kinetic-design/kd-bms-v2/README.md

# kd-bms-v2
Battery Monitoring System Version 2.0 for 192 cells
Designed by Steve Schulz
Kicad V5.1.6 
LTC6804-2 based
