kinetic-design/kd-bms-v2/kd-bms-v2.kicad_pcb

## KiCad design kd-bms-v2.kicad_pcb (2020-07-24)

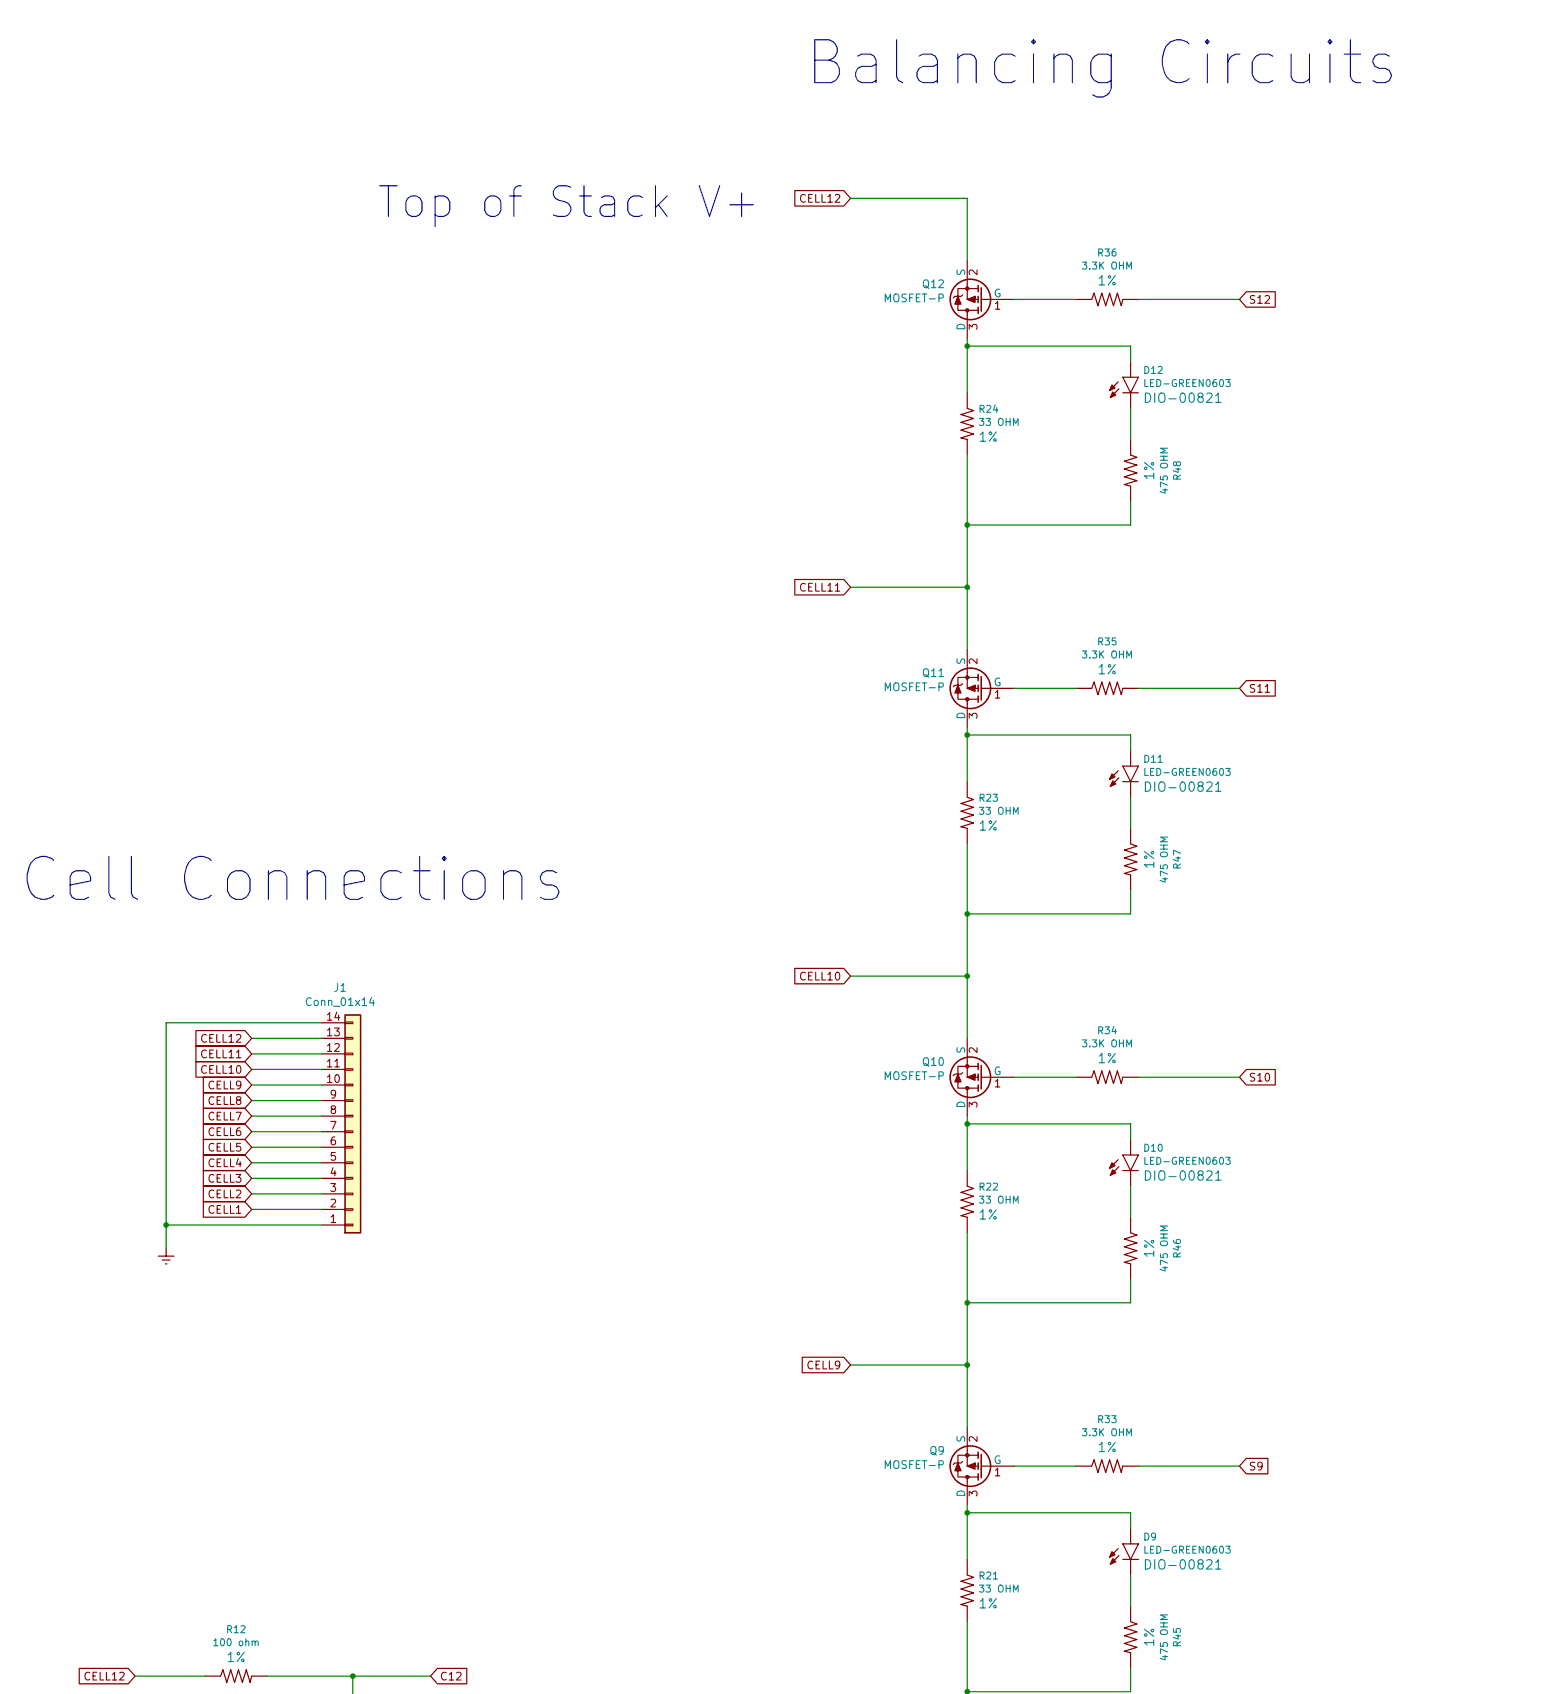
[picture p1: schematic kd-bms-v2.sch, LTC6804IG-2 BMS Slave, part in row 1, column 1]

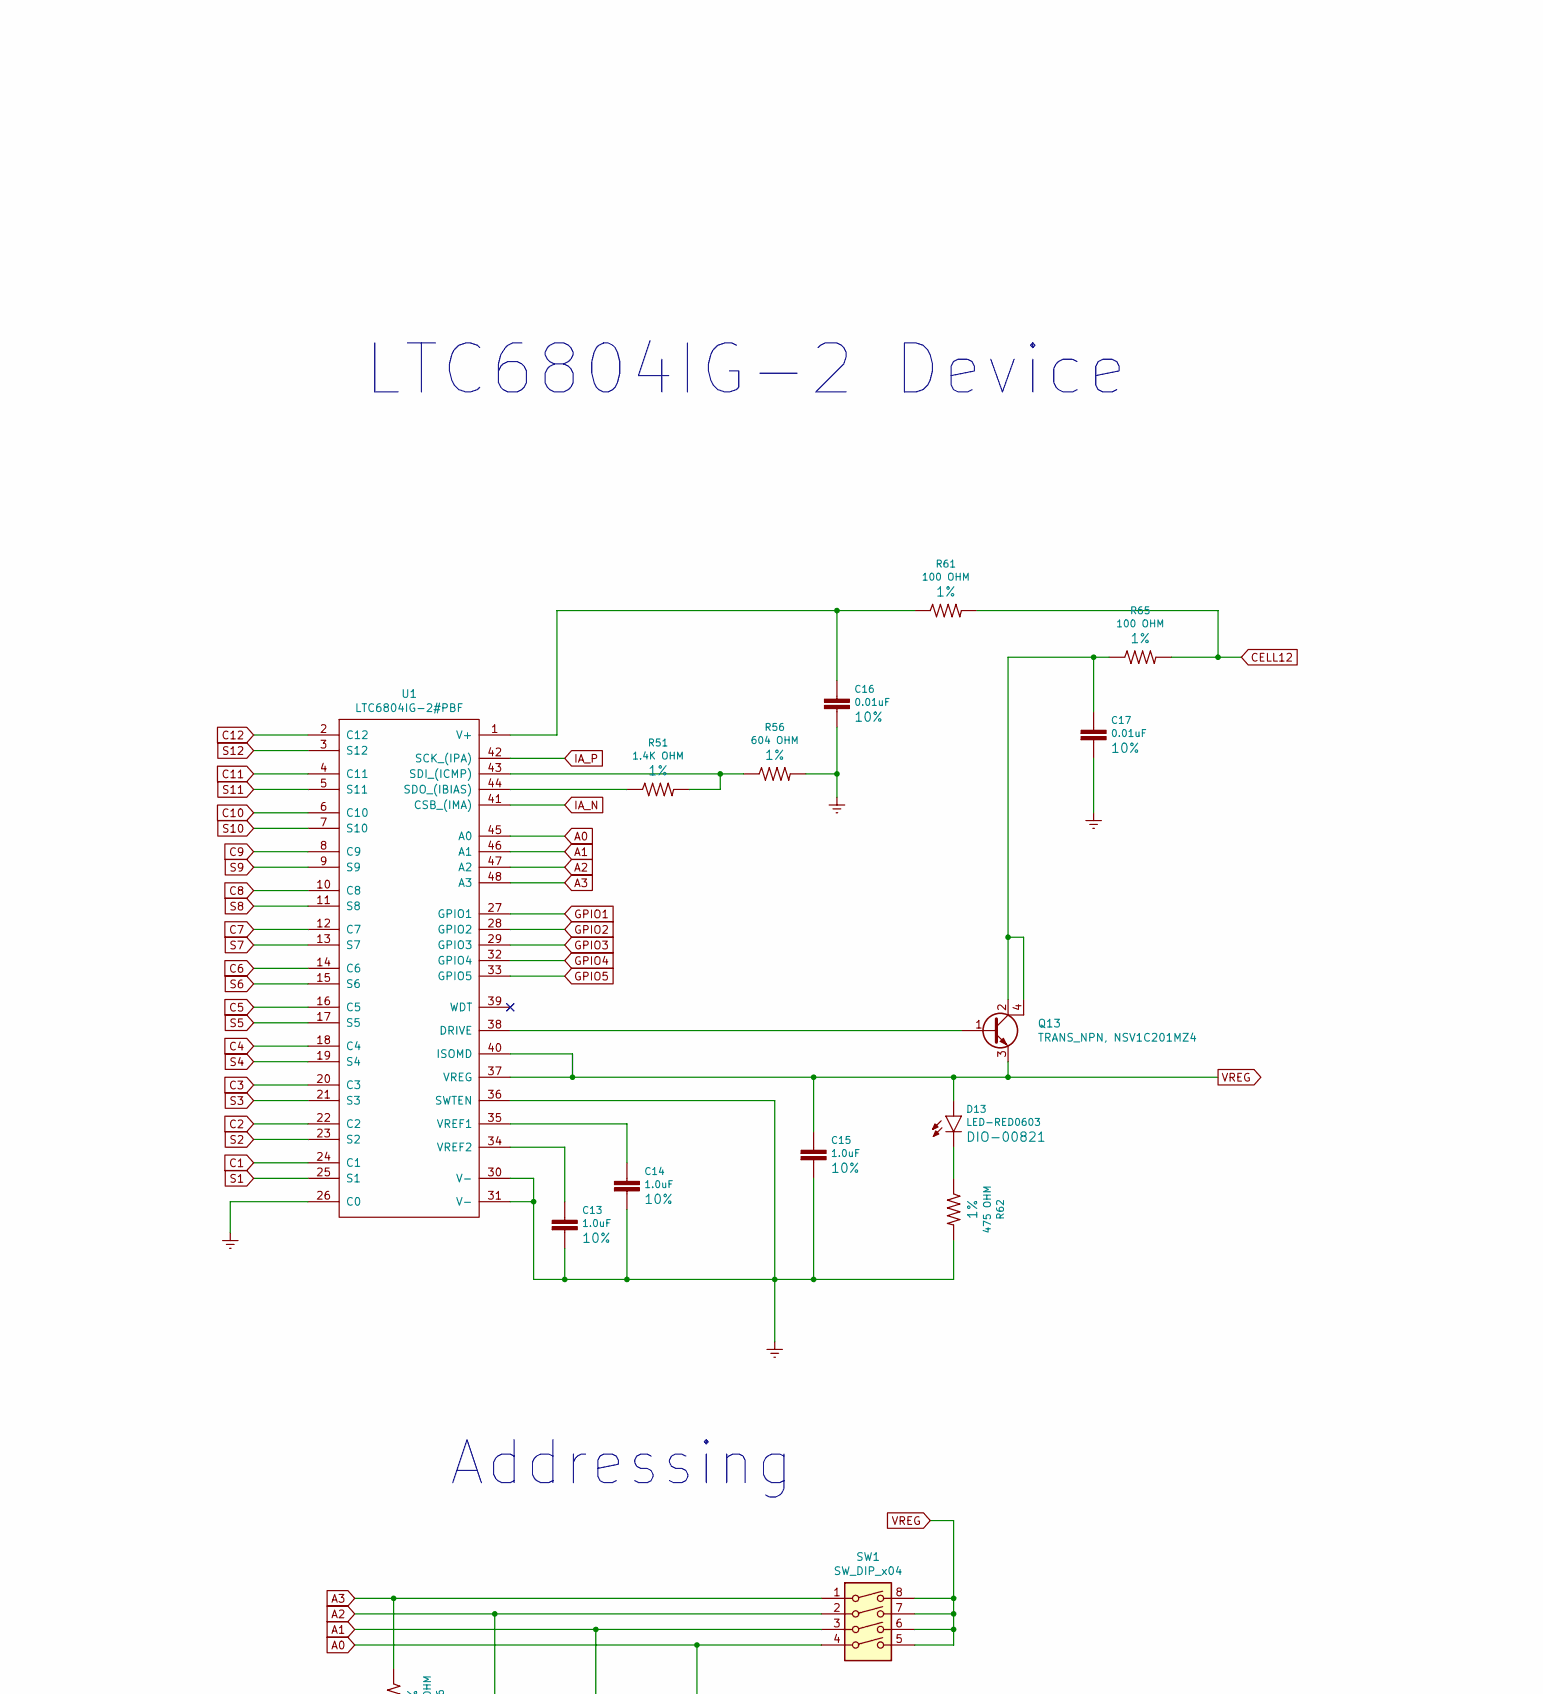
[picture p2: schematic kd-bms-v2.sch, LTC6804IG-2 BMS Slave, part in row 1, column 2]

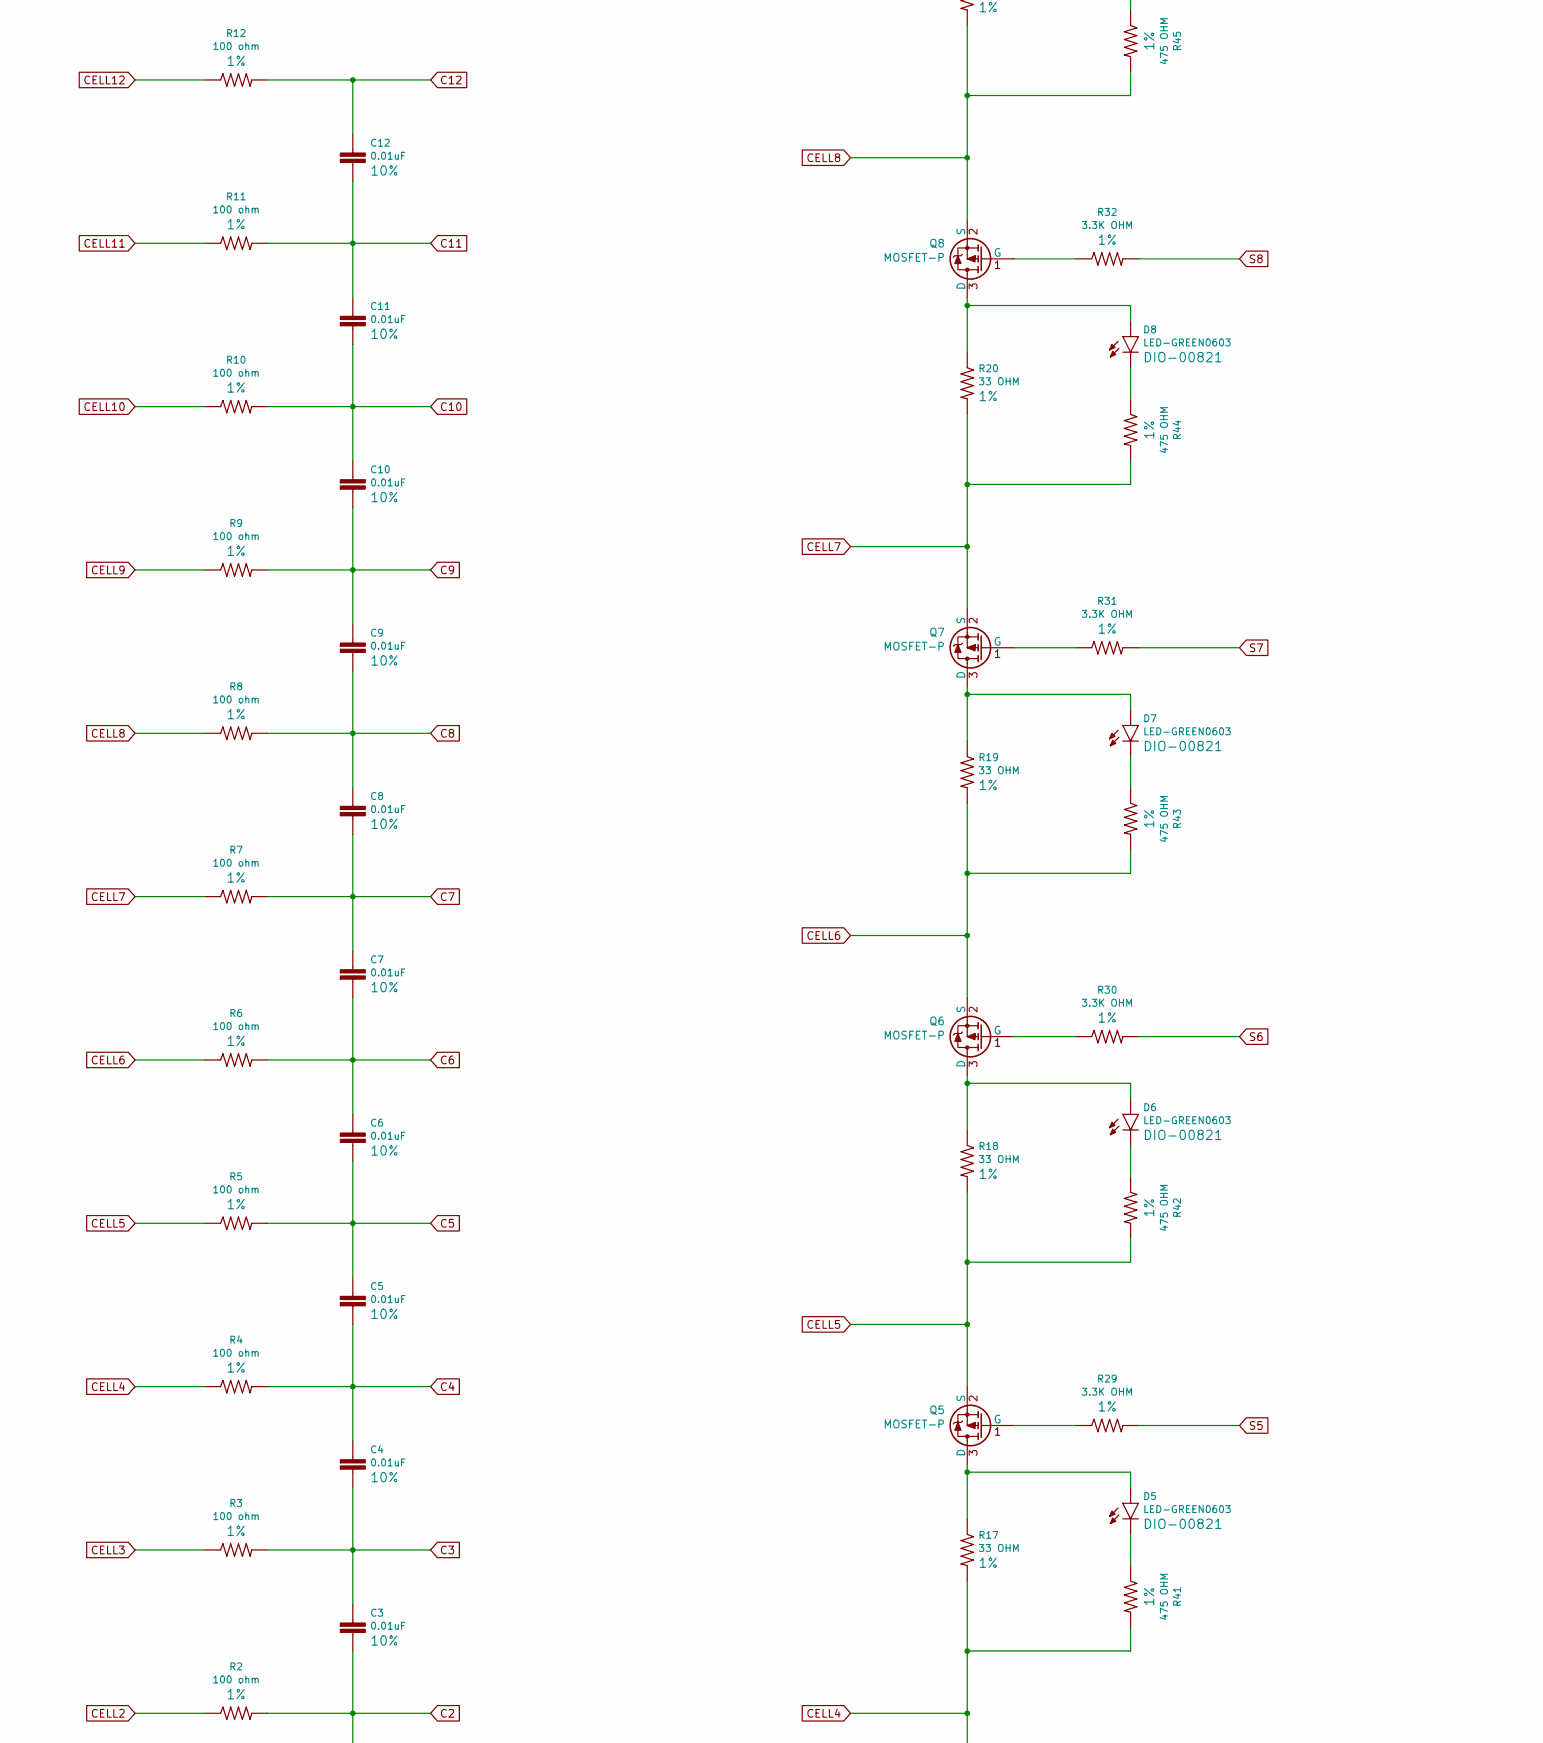
[picture p3: schematic kd-bms-v2.sch, LTC6804IG-2 BMS Slave, part in row 2, column 1]

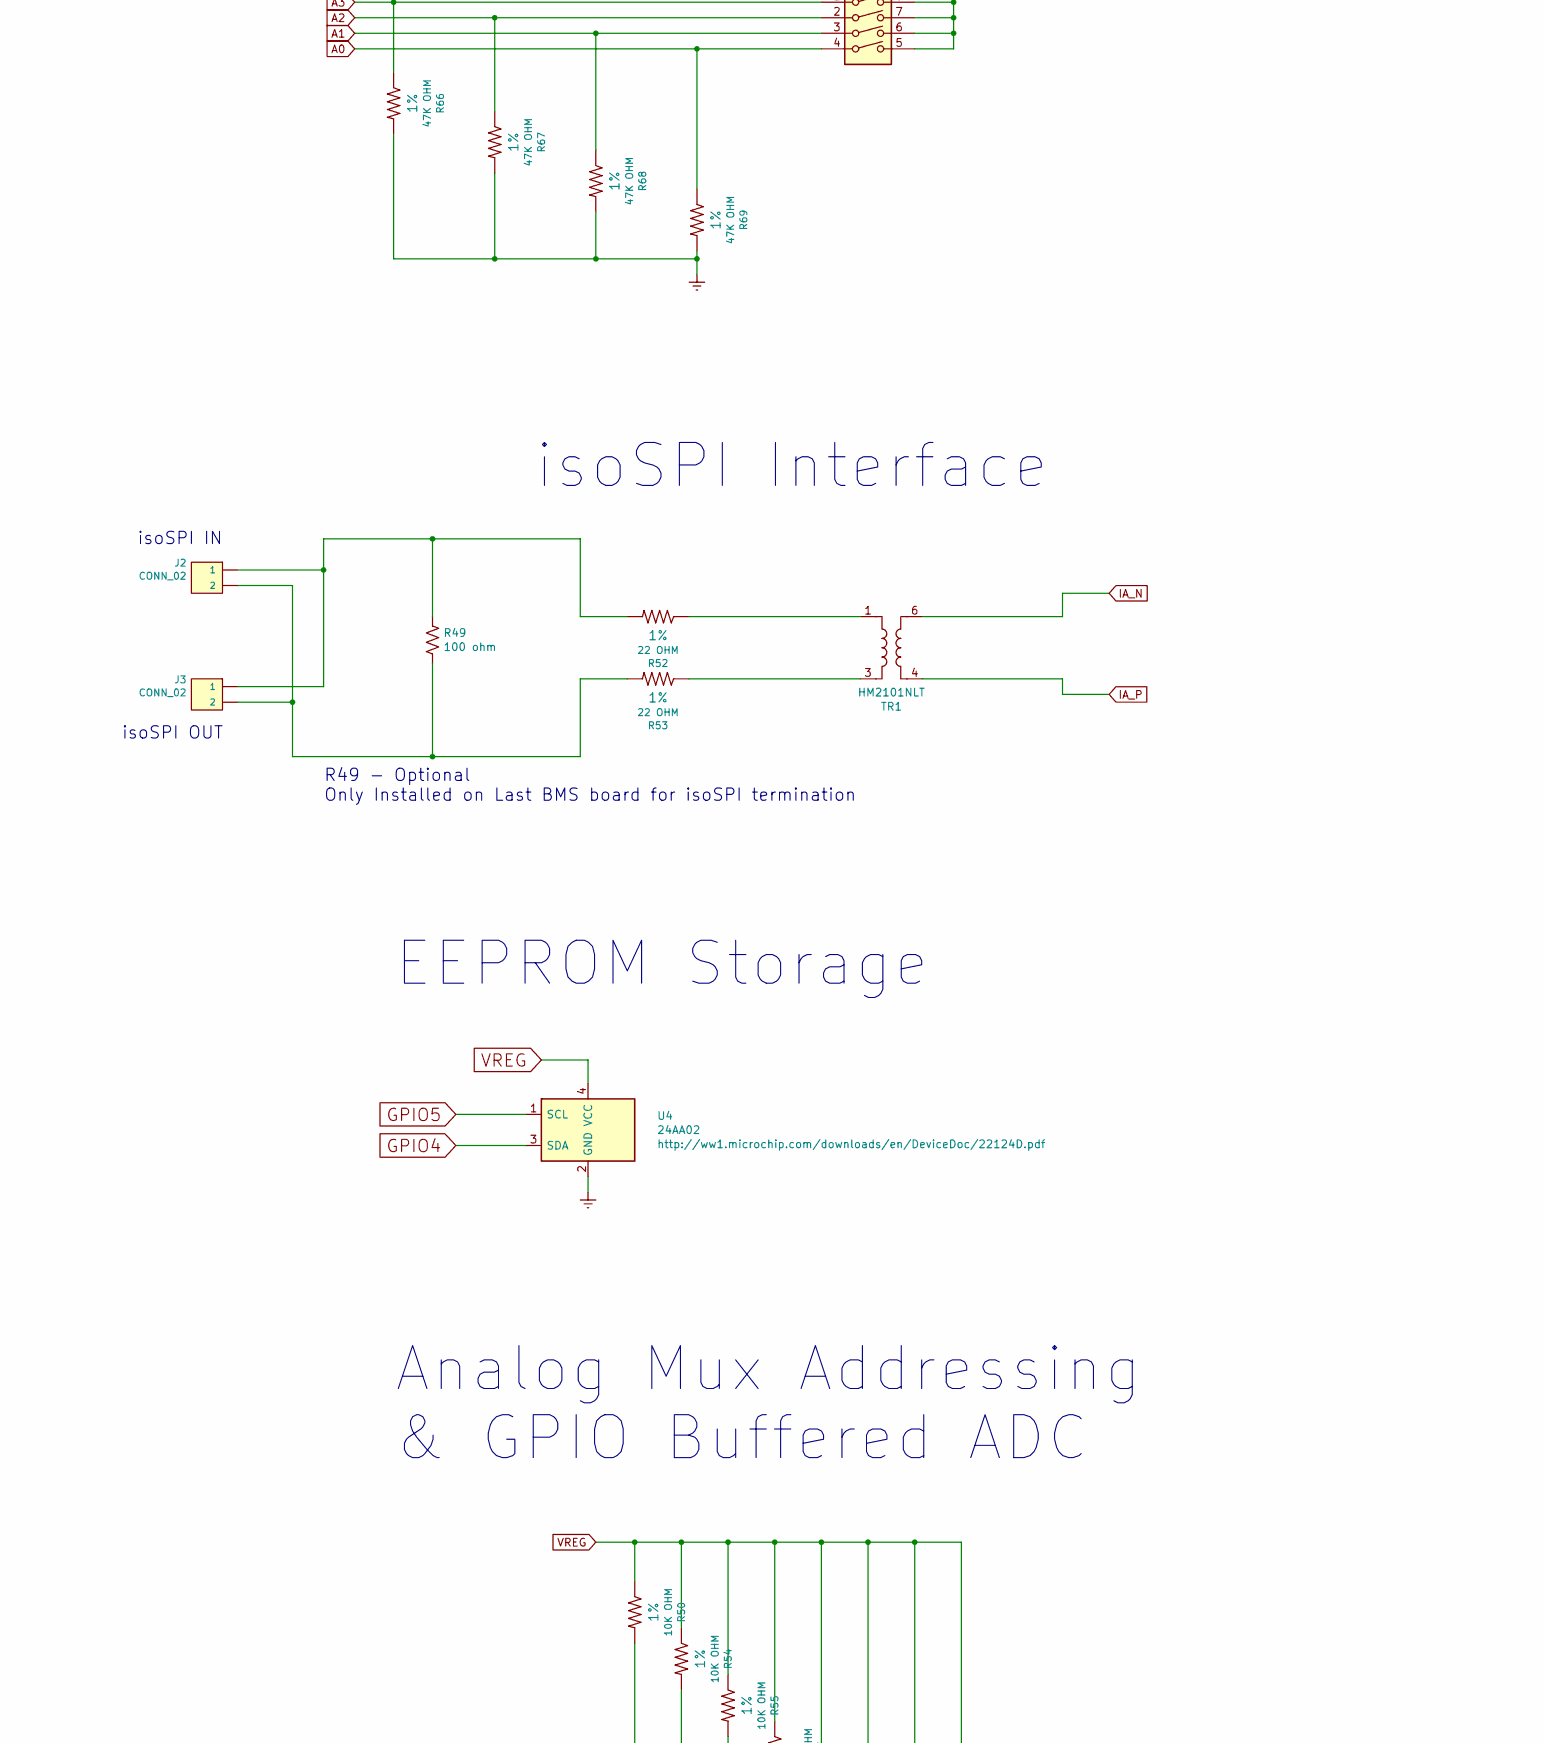
[picture p4: schematic kd-bms-v2.sch, LTC6804IG-2 BMS Slave, part in row 2, column 2]

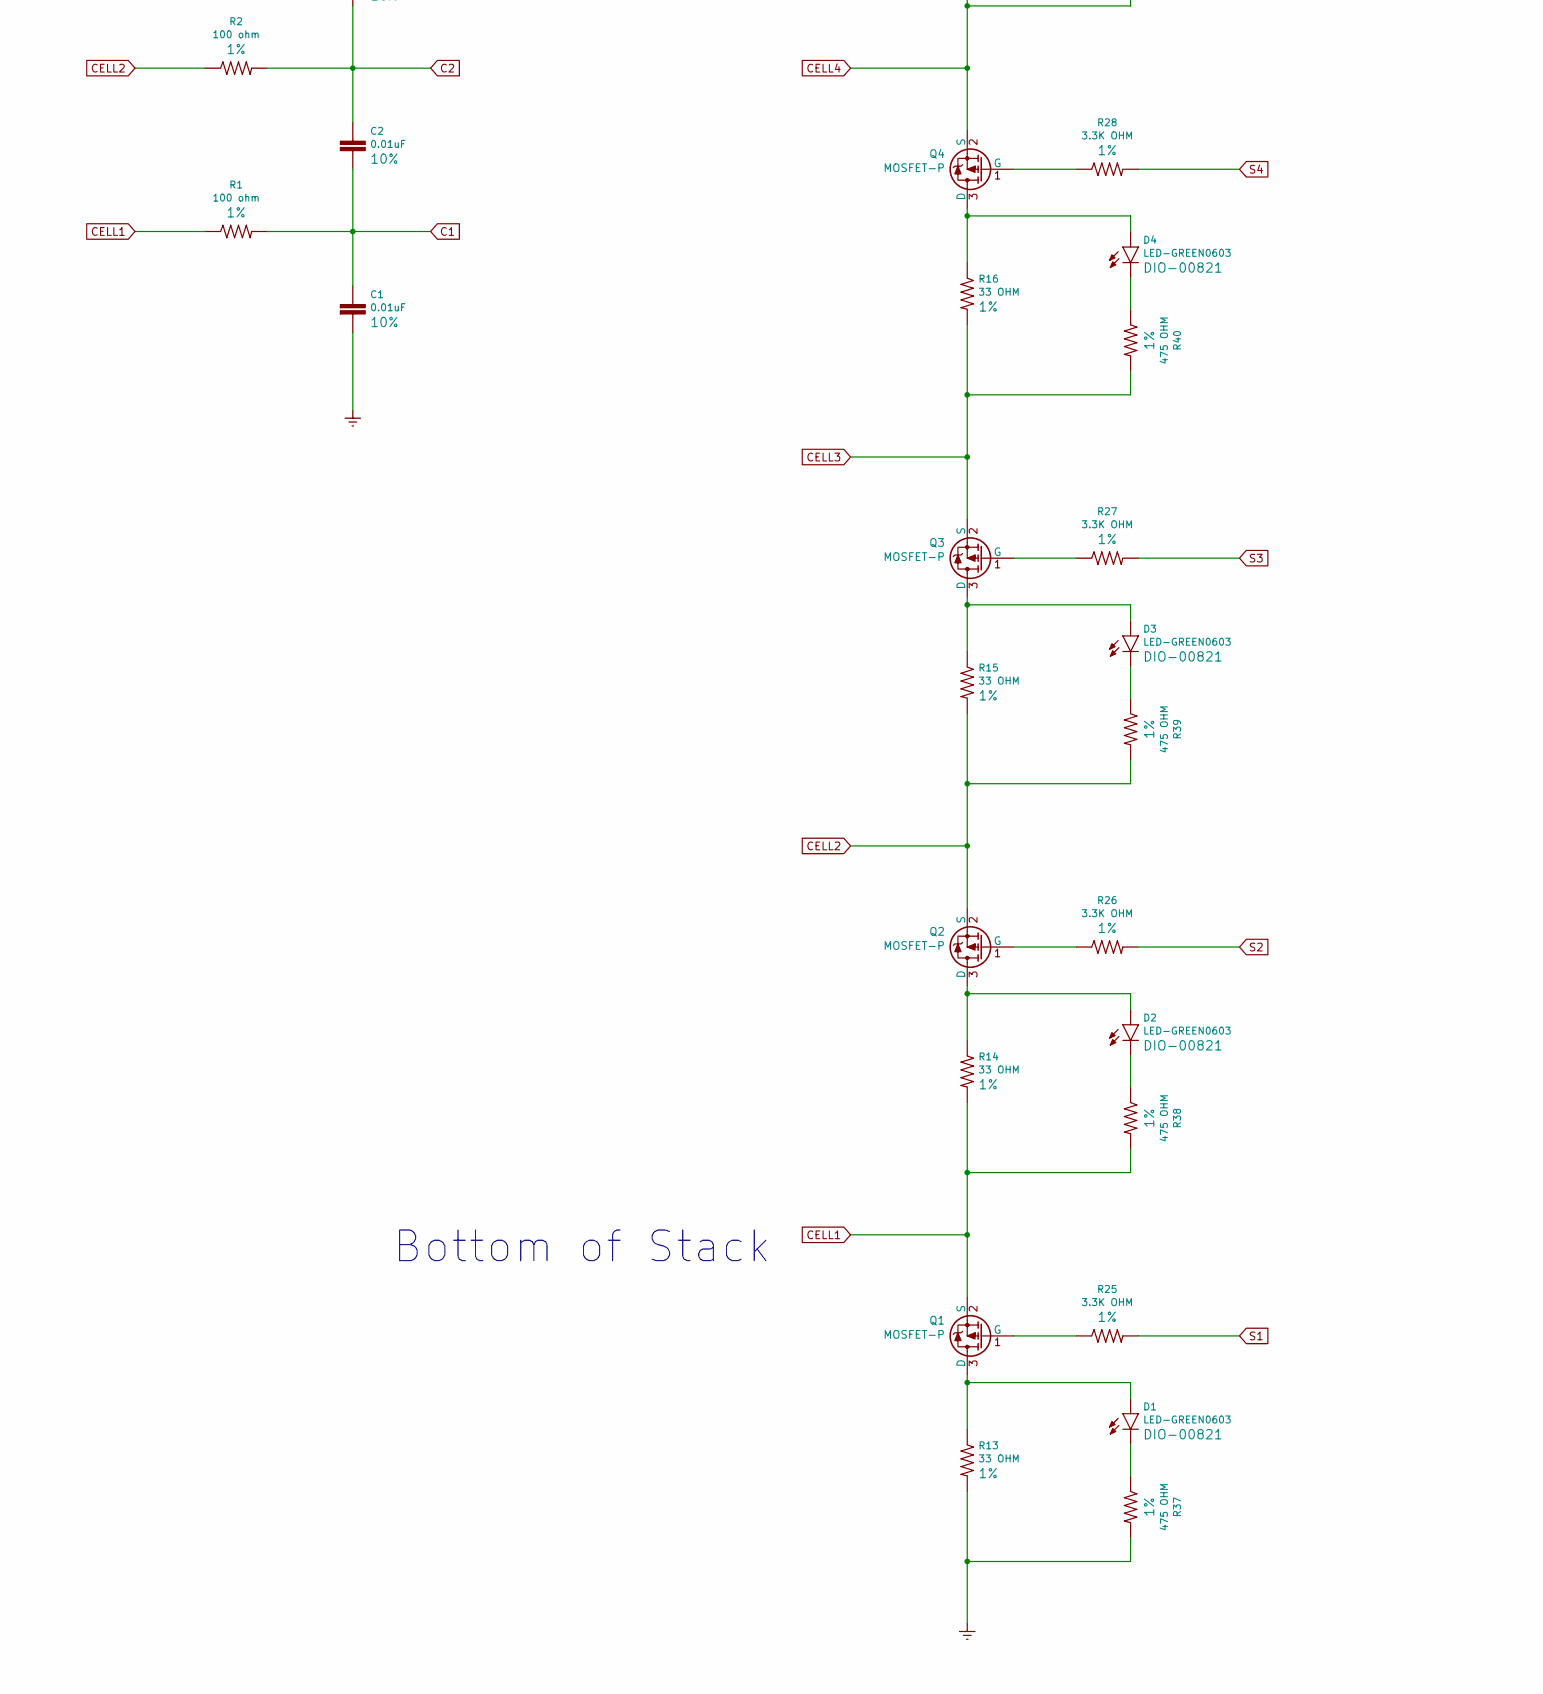
[picture p5: schematic kd-bms-v2.sch, LTC6804IG-2 BMS Slave, part in row 3, column 1]

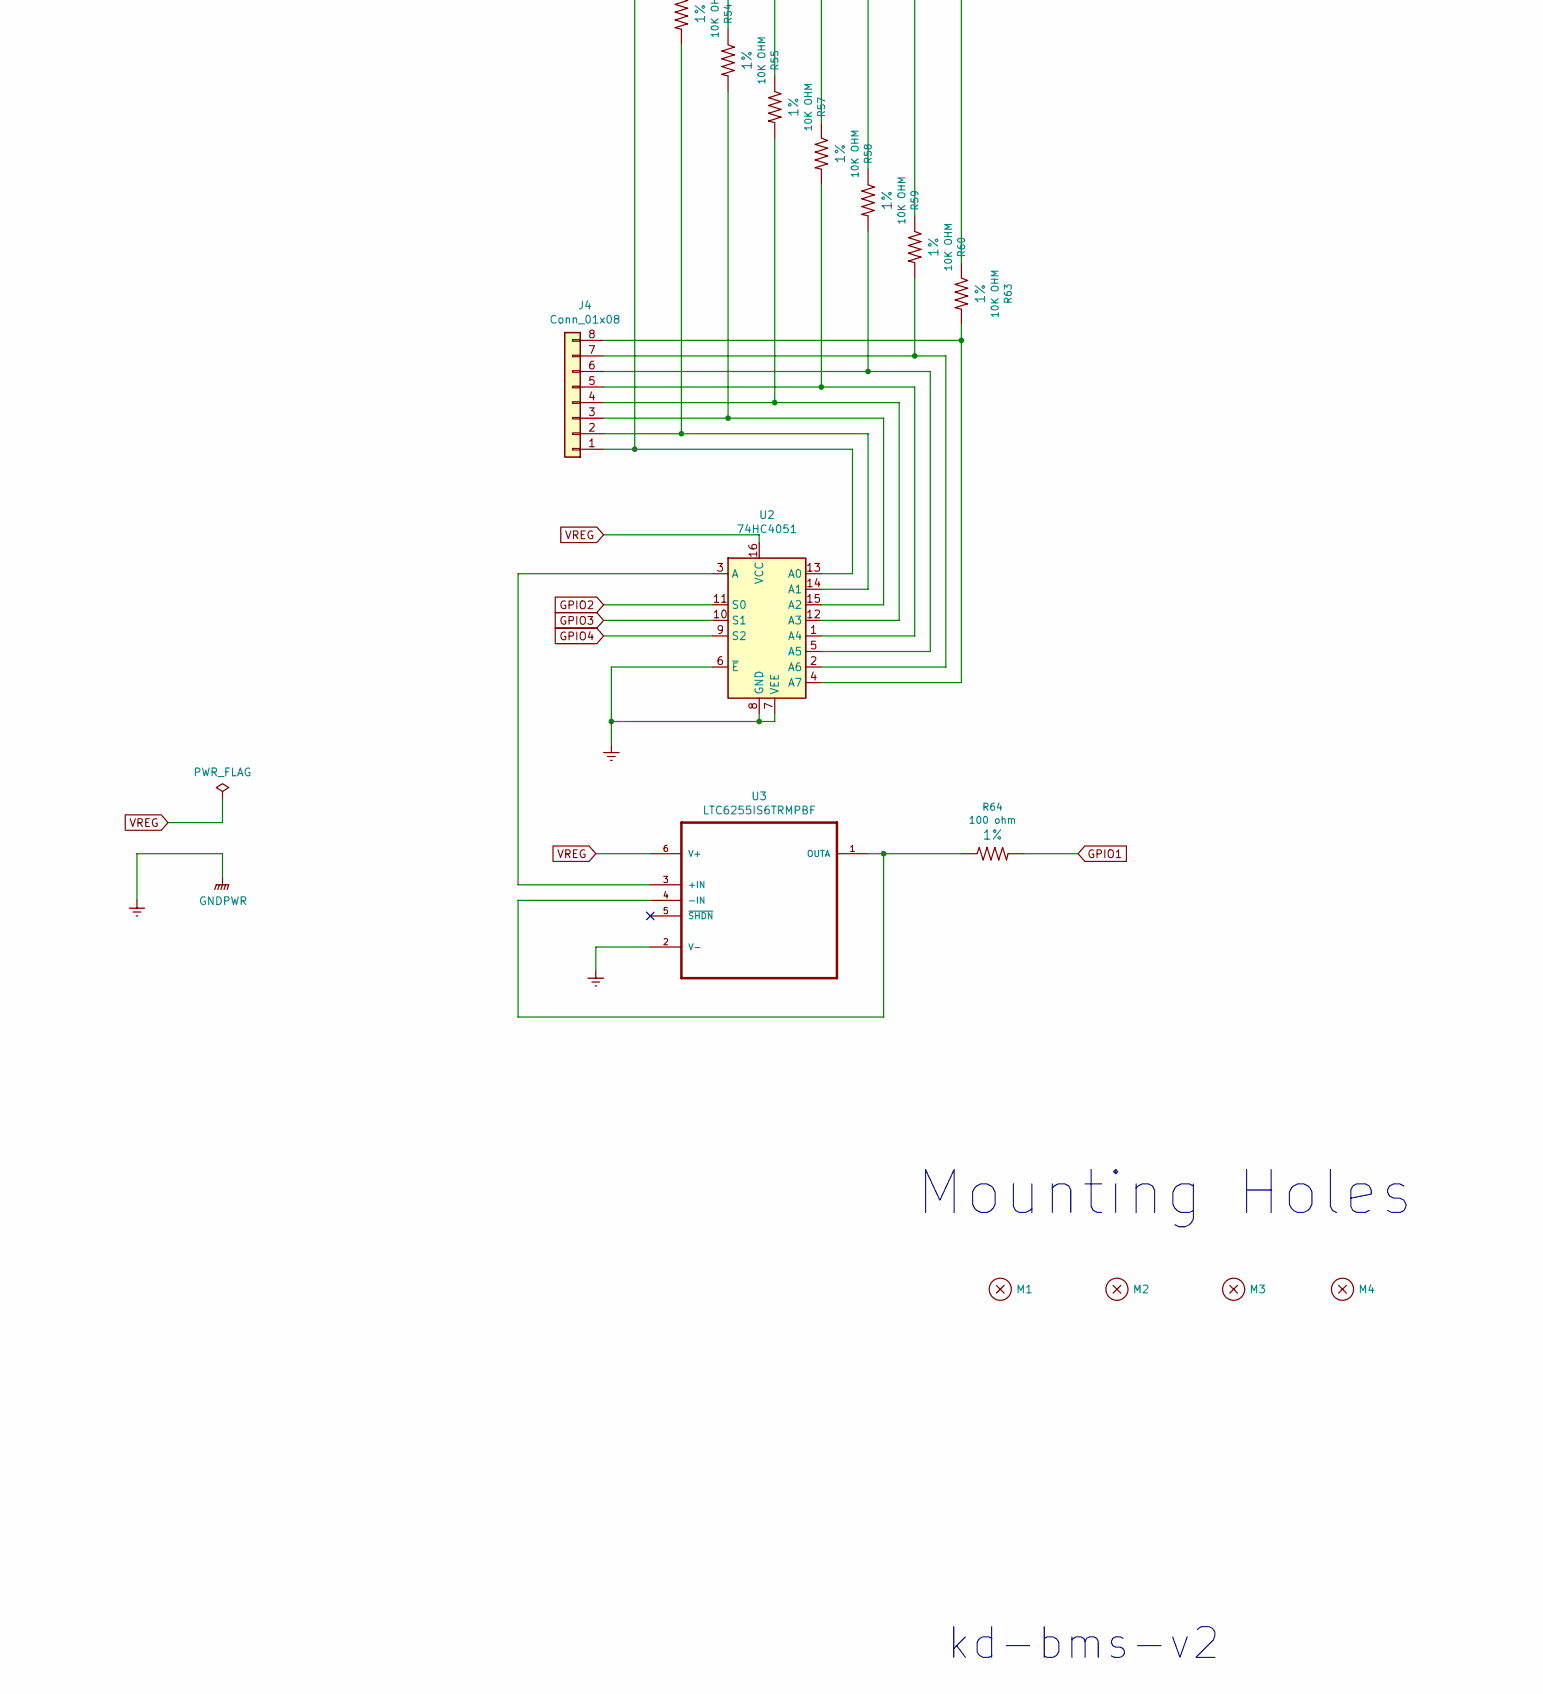
[picture p6: schematic kd-bms-v2.sch, LTC6804IG-2 BMS Slave, part in row 3, column 2]

Parts:
C1, C2, C3, C4, C5, C6, C7, C8, C9, C10, C11, C12: 0.01uF; 0603; Tolerance 10%; Voltage 50V
C13, C14, C15: 1.0uF; 0805; Tolerance 10%; Voltage 100V
C16, C17: 0.01uF; 0805; Tolerance 10%; Voltage 100V
D1, D2, D3, D4, D5, D6, D7, D8, D9, D10, D11, D12: LED-GREEN0603; LED-0603; Tolerance DIO-00821; Voltage 5v
D13: LED-RED0603; LED-0603; Tolerance DIO-00821; Voltage 5v
J1: Conn_01x14; 1X14; Tolerance NA; Voltage 100V
J2, J3: CONN_02; 1X02
J4: Conn_01x08; 1X08; Tolerance NA; Voltage 100V
M1, M2, M3, M4: MOUNT_HOLE; STAND-OFF
Q1, Q2, Q3, Q4, Q5, Q6, Q7, Q8, Q9, Q10, Q11, Q12: MOSFET-P; SOT23-3; Tolerance unipolar; Voltage -30V
Q13: TRANS_NPN, NSV1C201MZ4; SOT-223; Tolerance automotive; Voltage 100V
R1, R2, R3, R4, R5, R6, R7, R8, R9, R10, R11, R12, R64: 100 ohm; 0603; Tolerance 1%; Voltage 50V
R13, R14, R15, R16, R17, R18, R19, R20, R21, R22, R23, R24: 33 OHM; R_2512_6332Metric; Tolerance 1%; Voltage High
R25, R26, R27, R28, R29, R30, R31, R32, R33, R34, R35, R36: 3.3K OHM; 0603; Tolerance 1%; Voltage 50V
R37, R38, R39, R40, R41, R42, R43, R44, R45, R46, R47, R48, R62: 475 OHM; 0603; Tolerance 1%; Voltage 50V
R49: 100 ohm; R_0805_HandSoldering
R50, R54, R55, R57, R58, R59, R60, R63: 10K OHM; 0603; Tolerance 1%; Voltage 50V
R51: 1.4K OHM; 0603; Tolerance 1%; Voltage 50V
R52, R53: 22 OHM; 0603; Tolerance 1%; Voltage 50V
R56: 604 OHM; 0603; Tolerance 1%; Voltage 50V
R61, R65: 100 OHM; 0603; Tolerance 1%; Voltage 50V
R66, R67, R68, R69: 47K OHM; 0603; Tolerance 1%; Voltage 50V
SW1: SW_DIP_x04; DIPSWITCH-04-SMD; Tolerance 1000 cycles; Voltage 24VDC
TR1: HM2101NLT; Tolerance 2500V; Voltage 1000Vrms
U1: LTC6804IG-2#PBF; SOP50P780X200-48N
U2: 74HC4051; TSSOP16; Tolerance MIL-PRF-38535; Voltage 2v to 6v
U3: LTC6255IS6TRMPBF; SOT95P280X100-6N; Tolerance RRIO Op Amps; Voltage 1.8V to 5.25V
U4: 24AA02; SOT23-5; Tolerance Automotive; Voltage 1.8v to 5.5v

Connections:
A0: R69.1, SW1.4, U1.45 (A0)
A1: R68.1, SW1.3, U1.46 (A1)
A2: R67.1, SW1.2, U1.47 (A2)
A3: R66.1, SW1.1, U1.48 (A3)
C1: C1.1, C2.2, R1.2, U1.24 (C1)
C2: C2.1, C3.2, R2.2, U1.22 (C2)
C3: C3.1, C4.2, R3.2, U1.20 (C3)
C4: C4.1, C5.2, R4.2, U1.18 (C4)
C5: C5.1, C6.2, R5.2, U1.16 (C5)
C6: C6.1, C7.2, R6.2, U1.14 (C6)
C7: C7.1, C8.2, R7.2, U1.12 (C7)
C8: C8.1, C9.2, R8.2, U1.10 (C8)
C9: C9.1, C10.2, R9.2, U1.8 (C9)
C10: C10.1, C11.2, R10.2, U1.6 (C10)
C11: C11.1, C12.2, R11.2, U1.4 (C11)
C12: C12.1, R12.2, U1.2 (C12)
CELL1: J1.2, Q1.2 (S), R1.1, R14.2, R38.2
CELL2: J1.3, Q2.2 (S), R2.1, R15.2, R39.2
CELL3: J1.4, Q3.2 (S), R3.1, R16.2, R40.2
CELL4: J1.5, Q4.2 (S), R4.1, R17.2, R41.2
CELL5: J1.6, Q5.2 (S), R5.1, R18.2, R42.2
CELL6: J1.7, Q6.2 (S), R6.1, R19.2, R43.2
CELL7: J1.8, Q7.2 (S), R7.1, R20.2, R44.2
CELL8: J1.9, Q8.2 (S), R8.1, R21.2, R45.2
CELL9: J1.10, Q9.2 (S), R9.1, R22.2, R46.2
CELL10: J1.11, Q10.2 (S), R10.1, R23.2, R47.2
CELL11: J1.12, Q11.2 (S), R11.1, R24.2, R48.2
CELL12: J1.13, Q12.2 (S), R12.1, R61.2, R65.2
GND: C1.2, C13.2, C14.2, C15.2, C16.2, C17.2, J1.1, J1.14, R13.2, R37.2, R56.2, R62.2, R66.2, R67.2, R68.2, R69.2, U1.26 (C0), U1.30 (V-), U1.31 (V-), U1.36 (SWTEN), U2.6 (~E), U2.7 (VEE), U2.8 (GND), U3.2 (V-), U4.2 (GND)
GPIO1: R64.2, U1.27 (GPIO1)
GPIO2: U1.28 (GPIO2), U2.11 (S0)
GPIO3: U1.29 (GPIO3), U2.10 (S1)
GPIO4: U1.32 (GPIO4), U2.9 (S2), U4.3 (SDA)
GPIO5: U1.33 (GPIO5), U4.1 (SCL)
IA_N: TR1.6, U1.41 (CSB_(IMA))
IA_P: TR1.4, U1.42 (SCK_(IPA))
unnamed: C13.1, U1.34 (VREF2)
unnamed: C14.1, U1.35 (VREF1)
unnamed: C16.1, R61.1, U1.1 (V+)
unnamed: C17.1, Q13.2 (C), Q13.4 (C), R65.1
unnamed: D1.A, Q1.3 (D), R13.1
unnamed: D1.C, R37.1
unnamed: D2.A, Q2.3 (D), R14.1
unnamed: D2.C, R38.1
unnamed: D3.A, Q3.3 (D), R15.1
unnamed: D3.C, R39.1
unnamed: D4.A, Q4.3 (D), R16.1
unnamed: D4.C, R40.1
unnamed: D5.A, Q5.3 (D), R17.1
unnamed: D5.C, R41.1
unnamed: D6.A, Q6.3 (D), R18.1
unnamed: D6.C, R42.1
unnamed: D7.A, Q7.3 (D), R19.1
unnamed: D7.C, R43.1
unnamed: D8.A, Q8.3 (D), R20.1
unnamed: D8.C, R44.1
unnamed: D9.A, Q9.3 (D), R21.1
unnamed: D9.C, R45.1
unnamed: D10.A, Q10.3 (D), R22.1
unnamed: D10.C, R46.1
unnamed: D11.A, Q11.3 (D), R23.1
unnamed: D11.C, R47.1
unnamed: D12.A, Q12.3 (D), R24.1
unnamed: D12.C, R48.1
unnamed: D13.C, R62.1
unnamed: J2.1, J3.1, R49.1, R52.2
unnamed: J2.2, J3.2, R49.2, R53.2
unnamed: J4.1, R50.2, U2.13 (A0)
unnamed: J4.2, R54.2, U2.14 (A1)
unnamed: J4.3, R55.2, U2.15 (A2)
unnamed: J4.4, R57.2, U2.12 (A3)
unnamed: J4.5, R58.2, U2.1 (A4)
unnamed: J4.6, R59.2, U2.5 (A5)
unnamed: J4.7, R60.2, U2.2 (A6)
unnamed: J4.8, R63.2, U2.4 (A7)
unnamed: Q1.1 (G), R25.1
unnamed: Q2.1 (G), R26.1
unnamed: Q3.1 (G), R27.1
unnamed: Q4.1 (G), R28.1
unnamed: Q5.1 (G), R29.1
unnamed: Q6.1 (G), R30.1
unnamed: Q7.1 (G), R31.1
unnamed: Q8.1 (G), R32.1
unnamed: Q9.1 (G), R33.1
unnamed: Q10.1 (G), R34.1
unnamed: Q11.1 (G), R35.1
unnamed: Q12.1 (G), R36.1
unnamed: Q13.1 (B), U1.38 (DRIVE)
unnamed: R51.1, U1.44 (SDO_(IBIAS))
unnamed: R51.2, R56.1, U1.43 (SDI_(ICMP))
unnamed: R52.1, TR1.1
unnamed: R53.1, TR1.3
unnamed: R64.1, U3.1 (OUTA), U3.4 (-IN)
unnamed: U2.3 (A), U3.3 (+IN)
S1: R25.2, U1.25 (S1)
S2: R26.2, U1.23 (S2)
S3: R27.2, U1.21 (S3)
S4: R28.2, U1.19 (S4)
S5: R29.2, U1.17 (S5)
S6: R30.2, U1.15 (S6)
S7: R31.2, U1.13 (S7)
S8: R32.2, U1.11 (S8)
S9: R33.2, U1.9 (S9)
S10: R34.2, U1.7 (S10)
S11: R35.2, U1.5 (S11)
S12: R36.2, U1.3 (S12)
VREG: C15.1, D13.A, Q13.3 (E), R50.1, R54.1, R55.1, R57.1, R58.1, R59.1, R60.1, R63.1, SW1.5, SW1.6, SW1.7, SW1.8, U1.37 (VREG), U1.40 (ISOMD), U2.16 (VCC), U3.6 (V+), U4.4 (VCC)

Notes on the sheet:
Addressing
kd-bms-v2
isoSPI Interface
Analog Mux Addressing & GPIO Buffered ADC
LTC6804IG-2 Device
Cell Connections
Balancing Circuits
Mounting Holes
Top of Stack V+
Bottom of Stack
isoSPI OUT
isoSPI IN
EEPROM Storage
R49 - Optional Only Installed on Last BMS board for isoSPI termination

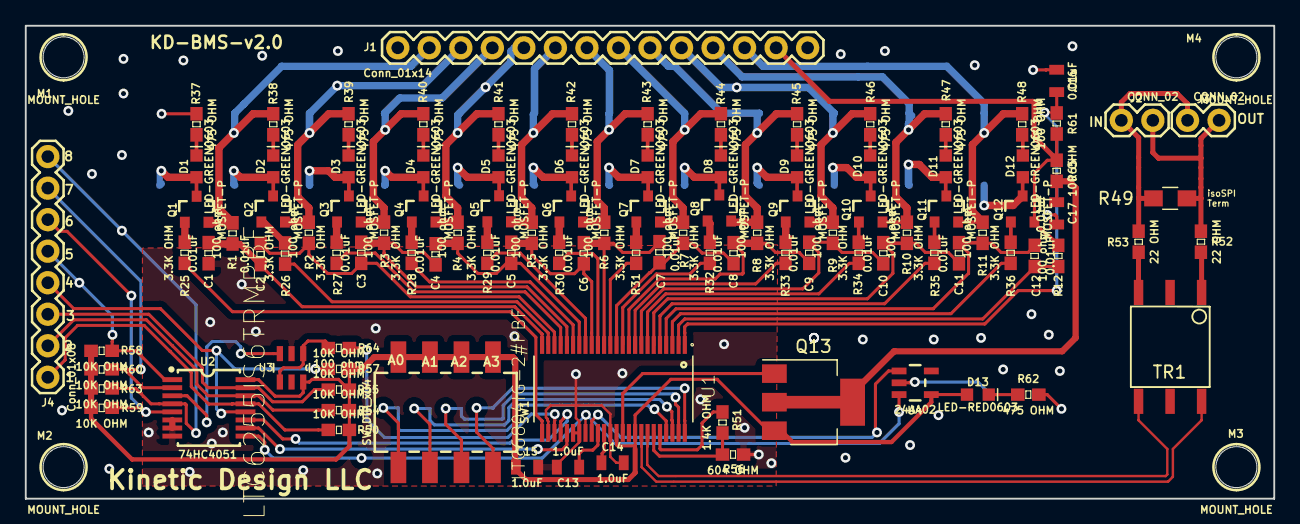
[picture p7: board kd-bms-v2.kicad_pcb from above]

Board: 4 copper layers, 100.6 x 38.1 mm, 126 parts (0 on the bottom side), 107 nets.
